RandomDelta6/9w_LED_Driver_PCB/Documentation/schematic.pdf

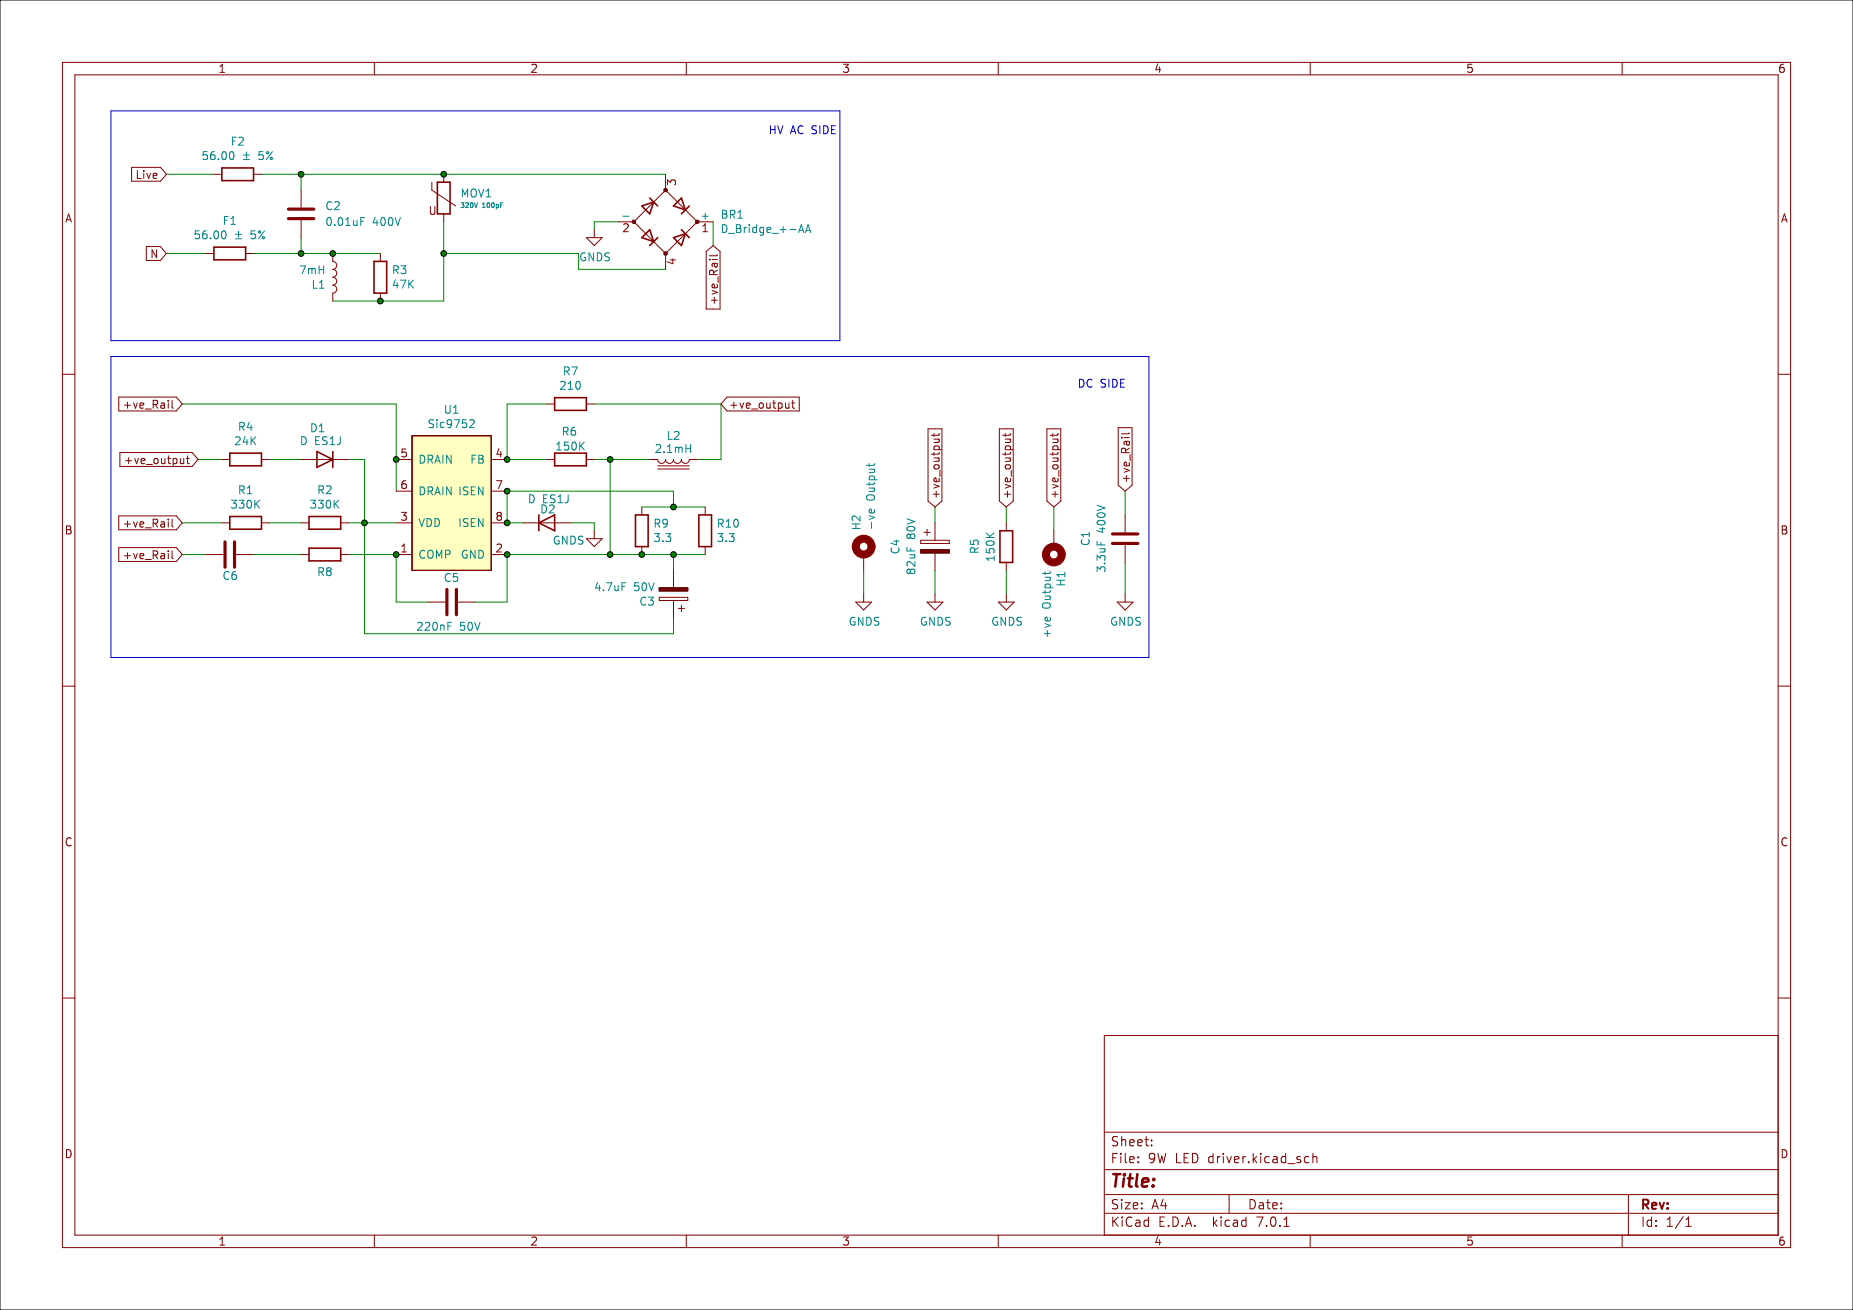
[picture p1: page 1]
