RandomDelta6/9w_LED_Driver_PCB/9W LED driver.kicad_pcb

## KiCad design 9W LED driver.kicad_pcb (2023-04-11)

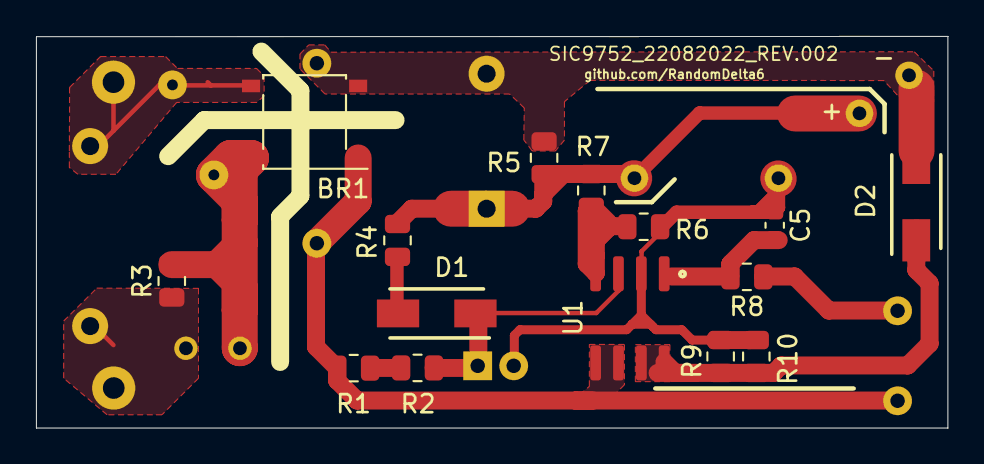
[picture p2: board 9W LED driver.kicad_pcb from above]

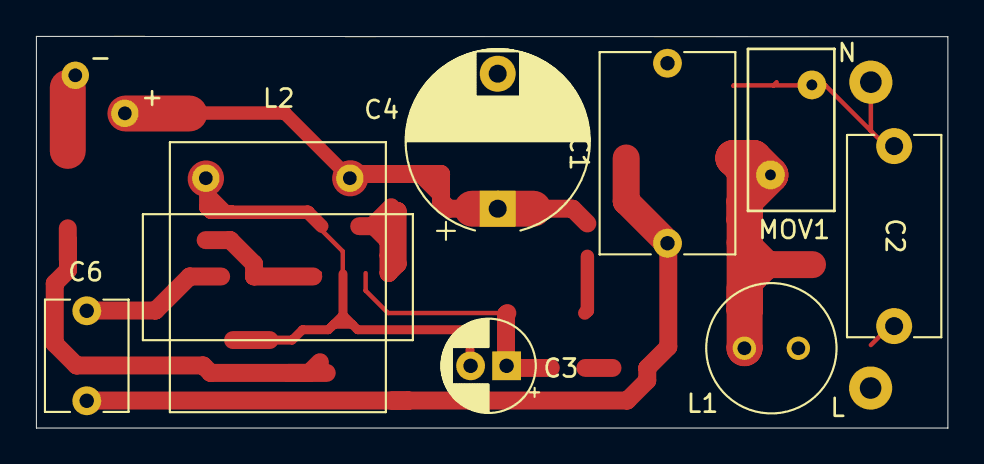
[picture p3: board 9W LED driver.kicad_pcb from below]

Board: 2 copper layers, 50.6 x 21.8 mm, 27 parts (10 on the bottom side), 14 nets.

Parts:
+: +ve Output; Pad
-: -ve Output; Pad
BR1: D_Bridge_+-AA; Diode_Bridge_Diotec_ABS
C1: 3.3uF 400V; C_Rect_L11.0mm_W7.3mm_P10.00mm_MKT
C2: 0.01uF 400V; C_Disc_D11.0mm_W5.0mm_P10.00mm
C3: 4.7uF 50V; CP_Radial_D5.0mm_P2.00mm
C4: 82uF 80V; CP_Radial_D10.0mm_P7.50mm
C5: 220nF 50V; C_0603_1608Metric
C6: C_Disc_D6.0mm_W4.4mm_P5.00mm
D1, D2: D ES1J; DIOM5227X250N
F1, F2: 56.00 ± 5%; R_Axial_DIN0411_L9.9mm_D3.6mm_P12.70mm_Horizontal
L1: 7mH; L_Radial_D7.0mm_P3.00mm
L2: 2.1mH; Inductor_Transformer
MOV1: 320V 100pF; RV_Disc_D9mm_W4.8mm_P5mm
R1, R2: 330K; R_0805_2012Metric
R3: 47K; R_0805_2012Metric
R4: 24K; R_0805_2012Metric
R5, R6: 150K; R_0805_2012Metric
R7: 210; R_0805_2012Metric
R8: R_0805_2012Metric
R9, R10: 3.3; R_0805_2012Metric
U1: Sic9752; SOIC-8_3.9x4.9mm_P1.27mm

Connections:
+ve_Rail: BR1.1 (+), C1.1, C6.2, R1.1, U1.5 (DRAIN), U1.6 (DRAIN)
+ve_output: +.1, C4.1, L2.1, R4.1, R5.1, R7.2
GNDS: -.1, BR1.2 (-), C1.2, C4.2, D2.2 (A), R5.2
unnamed: BR1.3, C2.2, F2.1, MOV1.1
unnamed: BR1.4, L1.2, MOV1.2, R3.2
unnamed: C2.1, F1.1, L1.1, R3.1
unnamed: C6.1, R8.1
unnamed: D1.2 (A), R4.2
unnamed: C3.1, D1.1 (K), R2.2, U1.3 (VDD)
unnamed: D2.1 (K), R9.1, R10.1, U1.7 (ISEN), U1.8 (ISEN)
unnamed: R1.2, R2.1
unnamed: C5.2, R8.2, U1.1 (COMP)
unnamed: R6.1, R7.1, U1.4 (FB)
unnamed: C3.2, C5.1, L2.2, R6.2, R9.2, R10.2, U1.2 (GND)
