RandomDelta6/9w_LED_Driver_PCB/(commit log)

2022-08-19 Layout Fix
    Fixed Layout issues and updated Silkscreen
    [9W LED driver.kicad_pcb, 9W LED driver.sch]
2022-08-25 refined design
    [9W LED driver.kicad_pcb, 9W LED driver.sch]
2023-01-26 fixed layout conflicts
    [Component Glossary.xlsx, EDI2CAP.CFG, ES1J.stl, ES1J.stp, chips.prt, diom5227x250n.psm]
2023-01-30 Updated Schematics
    [9W LED driver.kicad_pcb, 9W LED driver.sch]
2023-01-31 Updated PCB Layout
    [9W LED driver.kicad_pcb, 9W LED driver.sch]
2023-02-03 pcb revision
    [Component Glossary.csv]
2023-02-09 Schematic Correction
    [9W LED driver.kicad_pcb, 9W LED driver.sch]
2023-04-11 Fixed Schematic and Updated PCB
    [9W LED driver.kicad_pcb, 9W LED driver.kicad_sch, Component Glossary.csv, Component Glossary.xlsx]
2023-04-11 refine pcb layout
    [9W LED driver.kicad_pcb, 9W LED driver.sch]
